Otto17/fan_on_IR/4. Вид поворотного механизма сбоку.jpg

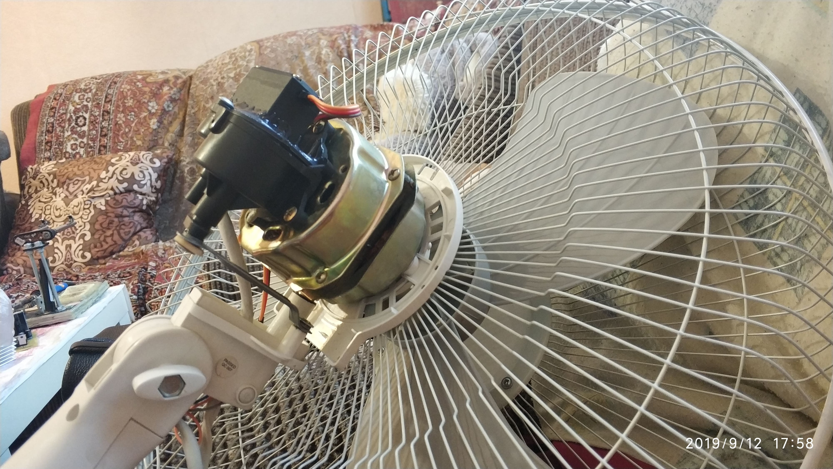
4. Вид поворотного механизма сбоку.jpg
