Otto17/fan_on_IR/2. Модернизированный вентилятор.jpg

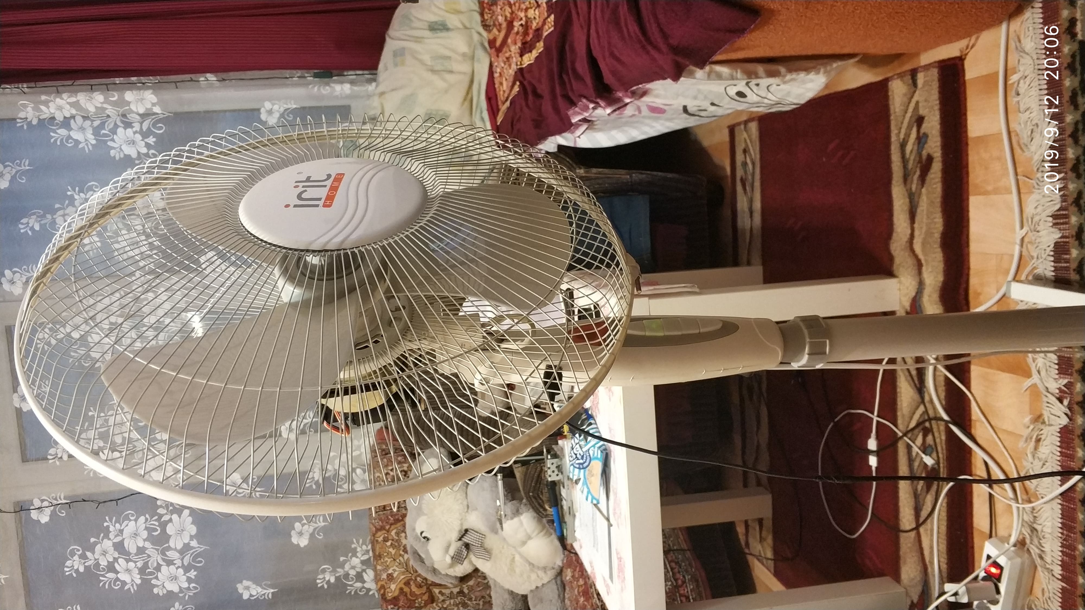
2. Модернизированный вентилятор.jpg
