Otto17/fan_on_IR/README.md

# Напольный вентилятор на ИК пульте (NEC)

В данном репозитории три версии вентилятора:  
Версия **"ver 0.x"** была когда только начал заниматься изучением Arduino и является "громоздкой" и неудобной.  
Версия **"ver 1.x"** получилась проходной, не очень удачной.  
Версия **"ver 2.x"** получилась самой компактной и стабильной, к тому же добавлена 4-я (пониженная) скорость вентилятора, больше дорабатывать особо нечего в ней.  
Версия **"ver 3.x"** переписана из версии 2.1, оптимизирована, удалены лишние библиотеки и обновлена библиотека NecDecoder с зависимостью GyverIO.

Проект делал лично для себя, выкладываю его сюда что бы не потерялся и может кто захочет повторить.

Ссылки на [GitFlic](https://gitflic.ru/project/otto/fanonir) и [GitHub](https://github.com/Otto17/fan_on_IR).
