Otto17/fan_on_IR/1. Вентилятор с ИК пультом на Arduino NANO 13.08.2016 (первая сырая версия).jpg

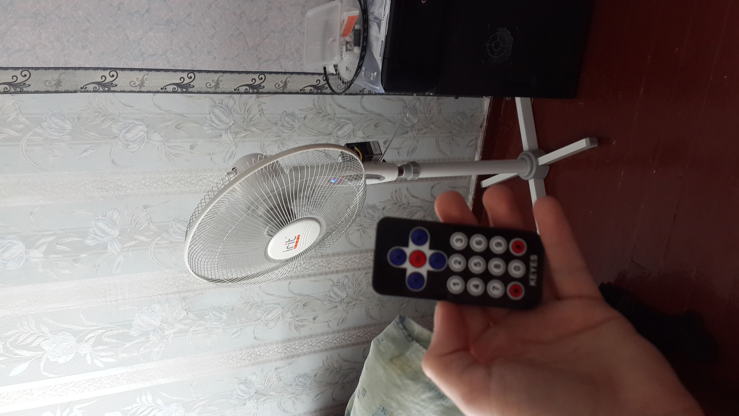
1. Вентилятор с ИК пультом на Arduino NANO 13.08.2016 (первая сырая версия).jpg
