Otto17/fan_on_IR/3. Заменил Серву на более мощную.jpg

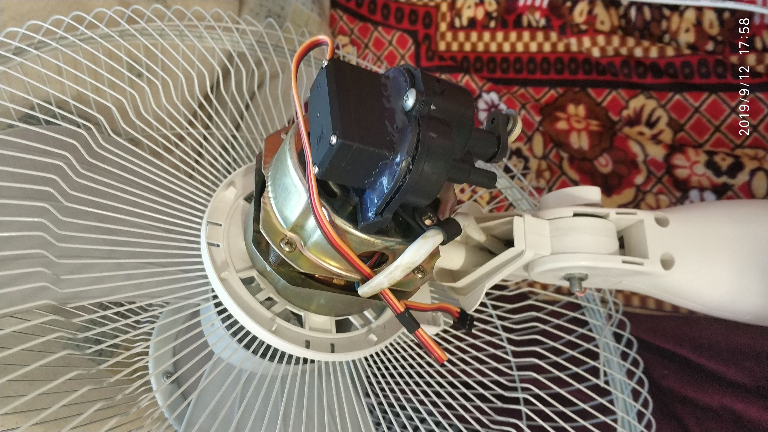
3. Заменил Серву на более мощную.jpg
