Otto17/fan_on_IR/5. Серва MG995.jpg

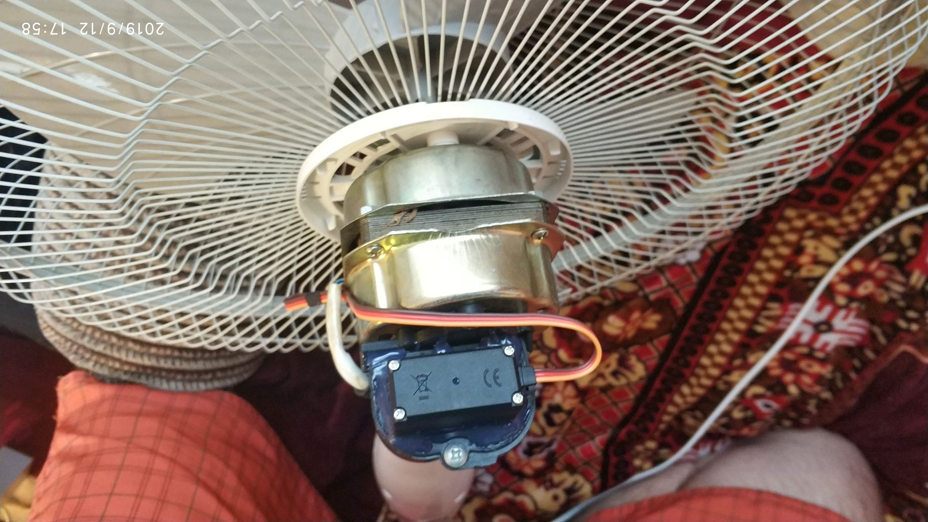
5. Серва MG995.jpg
