Otto17/fan_on_IR/6. Начинка.jpg

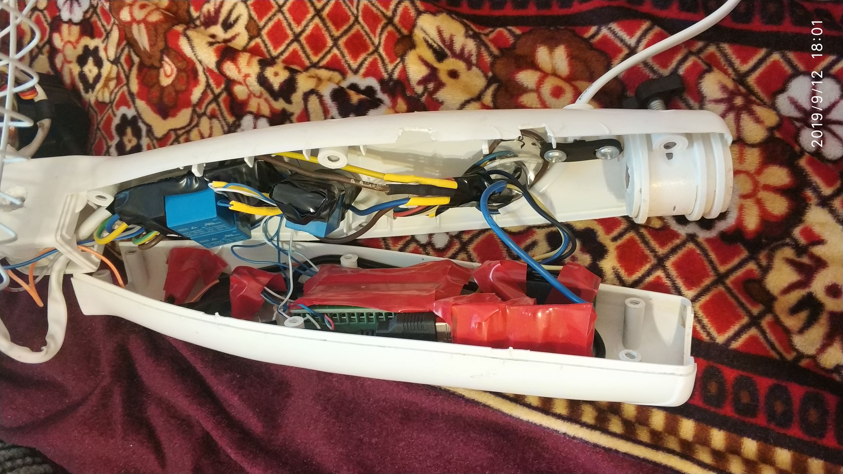
6. Начинка.jpg
