Otto17/fan_on_IR/7. Внутренности.jpg

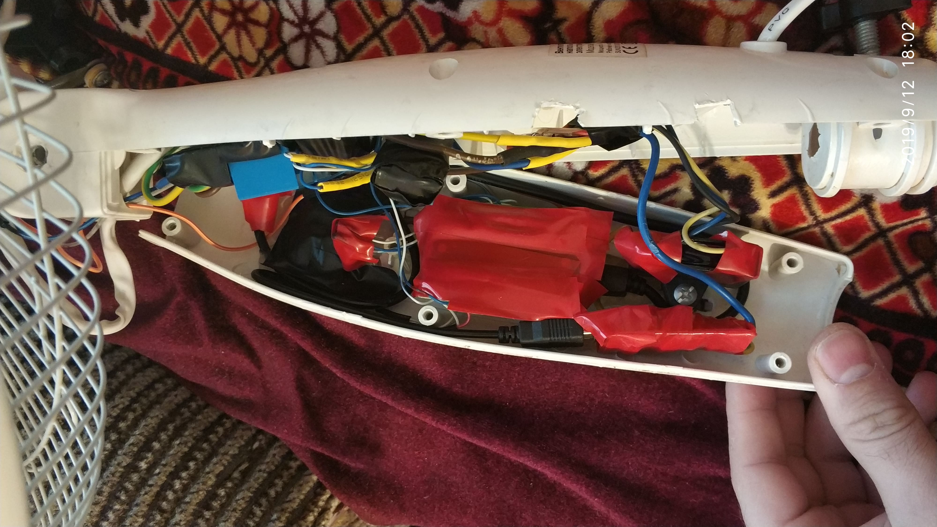
7. Внутренности.jpg
