Otto17/fan_on_IR/ver 3.x/schemes/Схема ver 2.x.gif

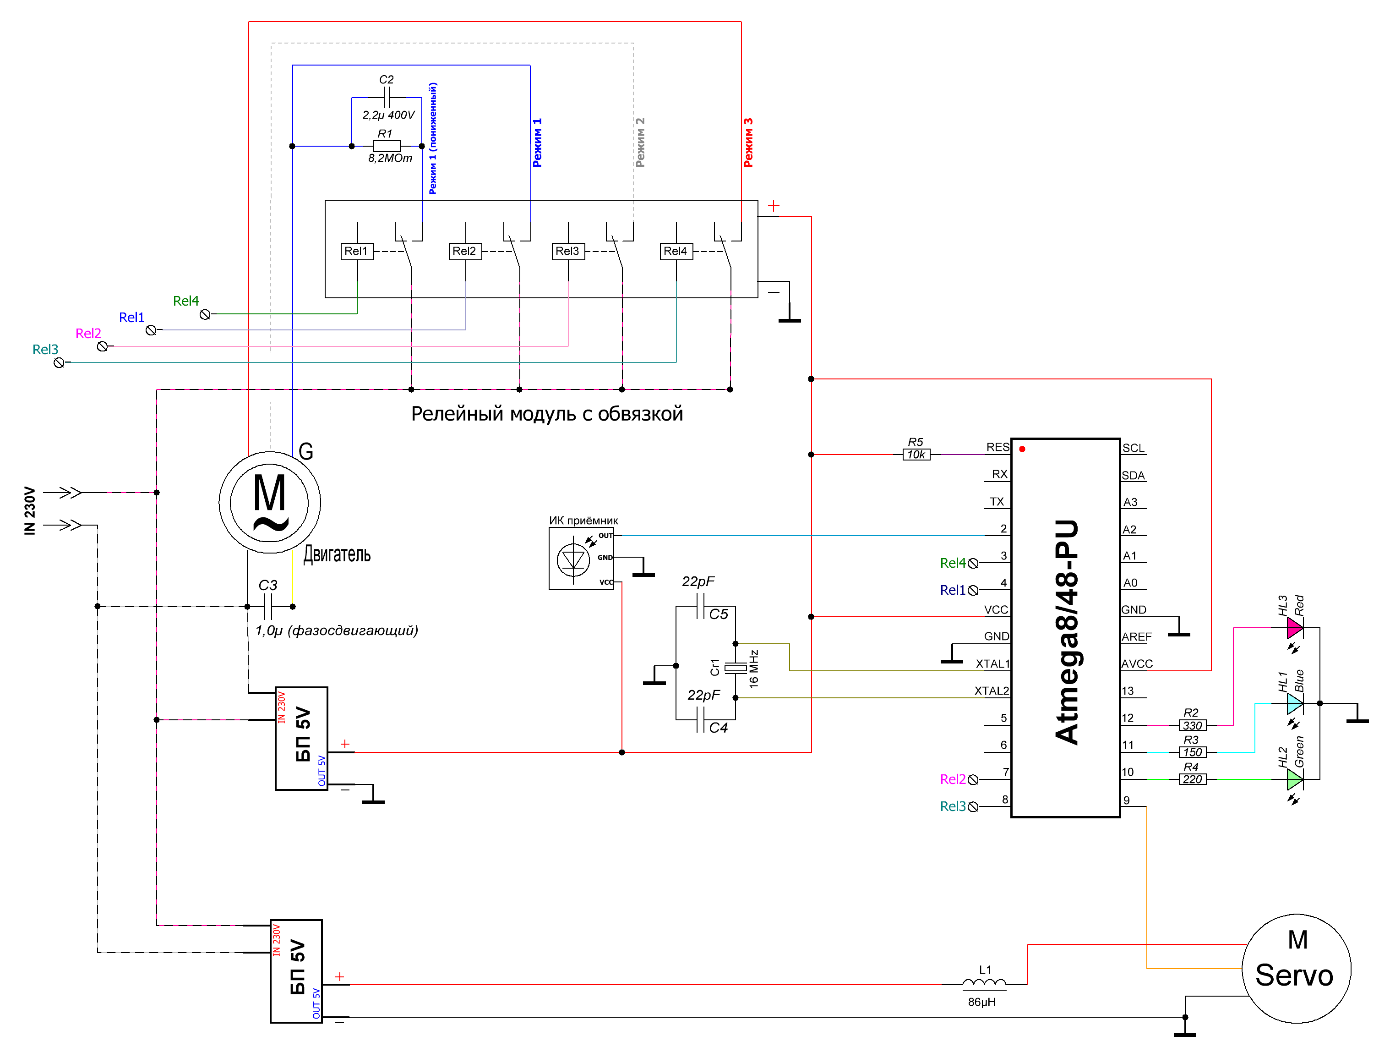
ver 3.x/schemes/Схема ver 2.x.gif
