Otto17/fan_on_IR/Подключение Мотора к реле.png

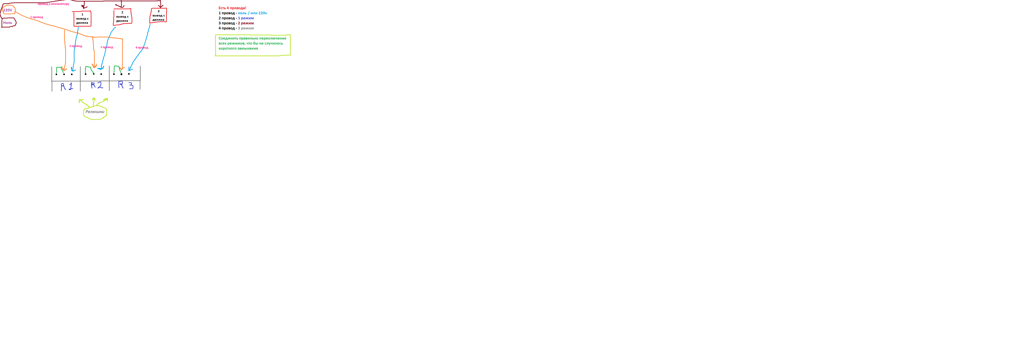
Подключение Мотора к реле.png
