Otto17/fan_on_IR/(list of files, drawings)

Other design files:
ver 1.x/Схема вентилятора на ИК.spl7
ver 3.x/schemes/Схема ver 2.x.spl7
