Otto17/fan_on_IR/ver 3.x/firmware/FAN_IR_3.0/globals.h

// Copyright (c) 2026 Otto
// Лицензия: MIT (см. LICENSE)

// ============================================================
// Структура таймера TimerOnce и extern объявления всех глобальных переменных
// ============================================================

#pragma once
#include <Arduino.h>
#include "config.h"

// ============================================================
//  Структура программного таймера-одновыстрела
// ============================================================
struct TimerOnce {
  uint32_t start_ms = 0;
  uint32_t period = 0;
  bool running = false;

  void begin(uint32_t prd) {
    period = prd;
    running = false;
  }

  void startTimer() {
    start_ms = millis();
    running = true;
  }

  void stopTimer() {
    running = false;
  }

  // Возвращает true ОДИН РАЗ при срабатывании
  bool tick() {
    if (!running) return false;
    if (millis() - start_ms >= period) {
      running = false;
      return true;
    }
    return false;
  }

  bool active() {
    return running;
  }
};

// ============================================================
//  Таймеры автовыключения
// ============================================================
extern TimerOnce mode1;
extern TimerOnce mode2;

// ============================================================
//  LED
// ============================================================
extern bool flagLED;
extern uint8_t regim_LED;

// ============================================================
//  Массивы пинов
// ============================================================
extern const uint8_t Relay_Array[4];
extern const uint8_t Led_Array[3];

// ============================================================
//  EEPROM
// ============================================================
extern bool flagWR;
extern uint16_t addr;
extern uint8_t eePos;

// ============================================================
//  Отложенная запись в EEPROM
// ============================================================
extern uint32_t ee_tmr;
extern bool ee_flag;

// ============================================================
//  Программный сервопривод
// ============================================================
extern uint16_t servo_us;
extern uint32_t servo_tmr_ms;
extern uint32_t servo_tmr_us;
extern bool servo_pulse_active;

// ============================================================
//  Автоповороты
// ============================================================
extern uint8_t servo_val;
extern int dir;
extern bool auto_RotatON;
extern uint32_t tmr_auto;

// ============================================================
//  Ручные повороты
// ============================================================
extern bool RotatON;
extern bool Right_Turns;
extern bool Left_Turns;
extern uint32_t manual_last_ir_ms;
extern uint32_t tmr_manual;

// ============================================================
//  Флаги защиты реле
// ============================================================
extern bool repeat[5];

// ============================================================
// Принудительное обновление LED (вызывать после смены состояния)
// ============================================================
void forceUpdateLED();
